poofypigeon/monostable-555/monostable_555.pdf

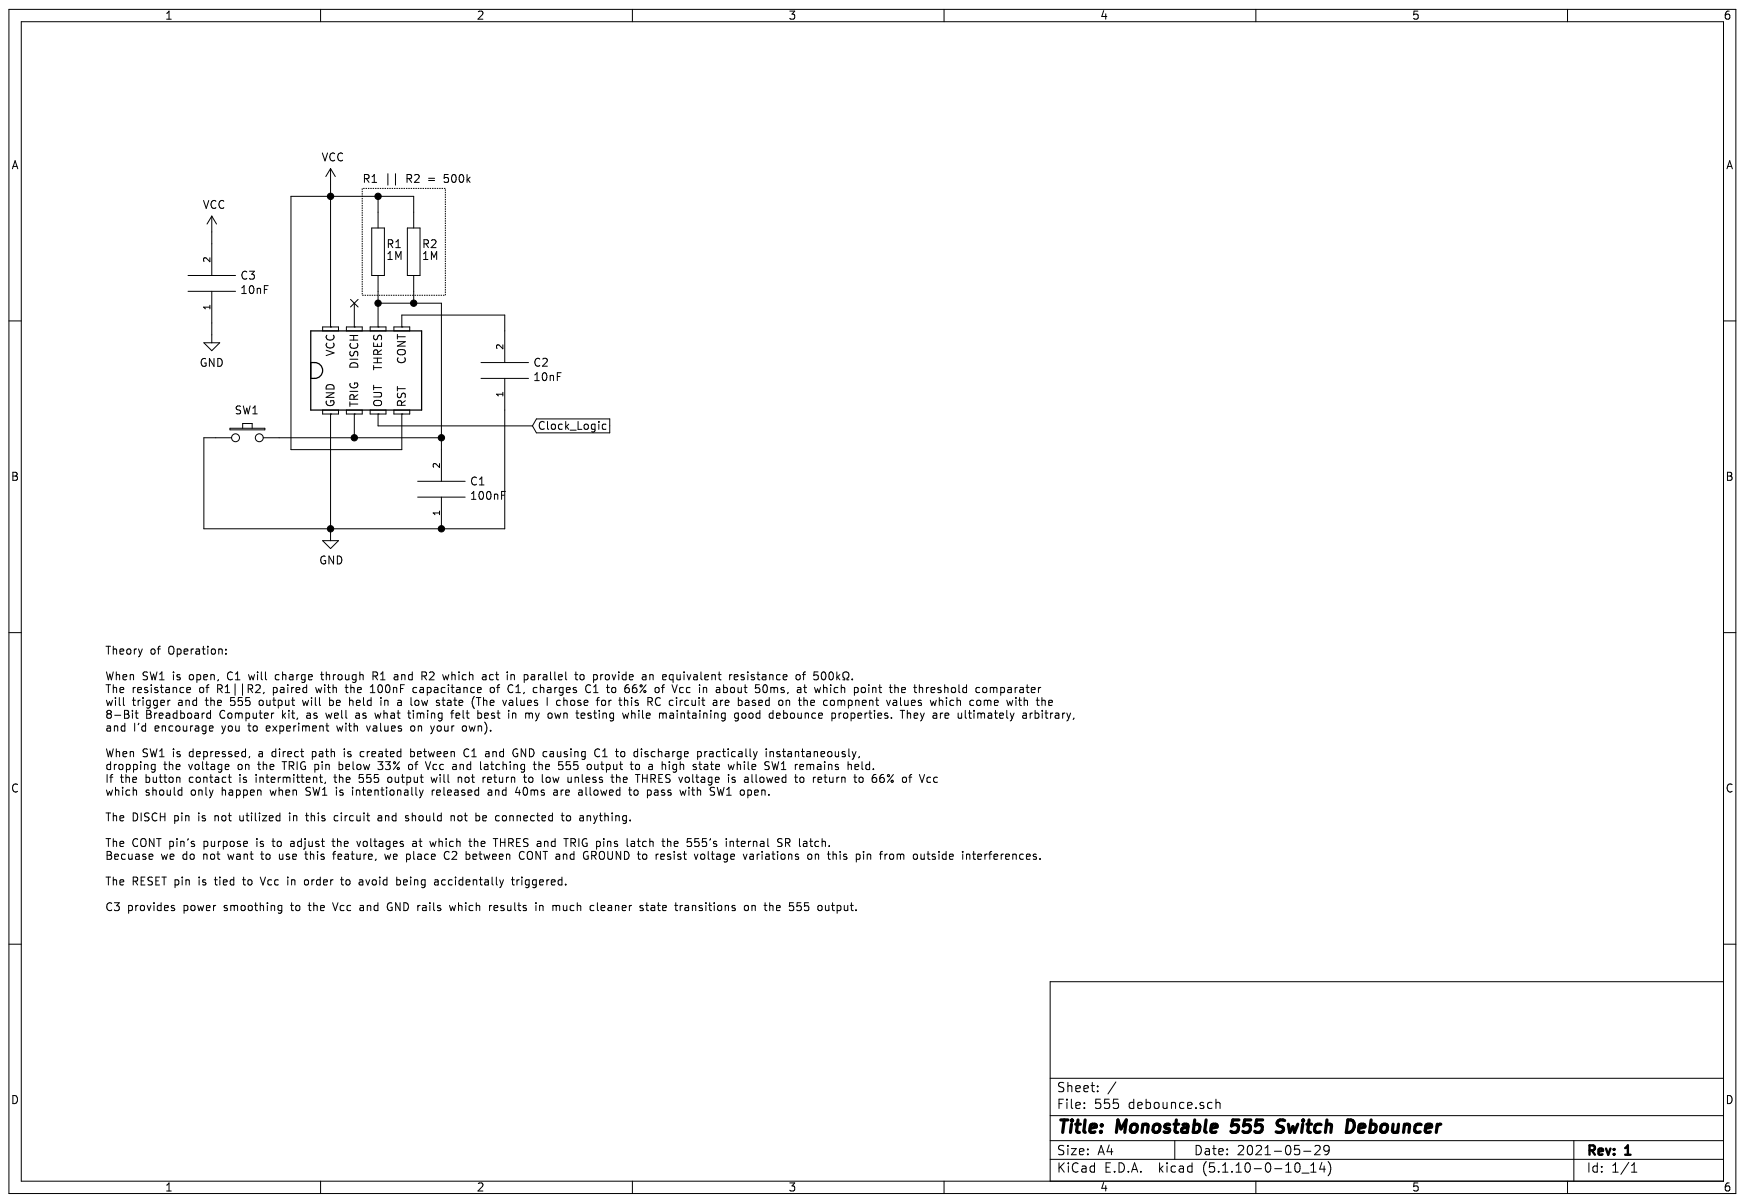
[picture p1: page 1]
