poofypigeon/monostable-555/kicad files/555 debounce.sch

## KiCad design kicad files/555 debounce.sch (2021-06-09)

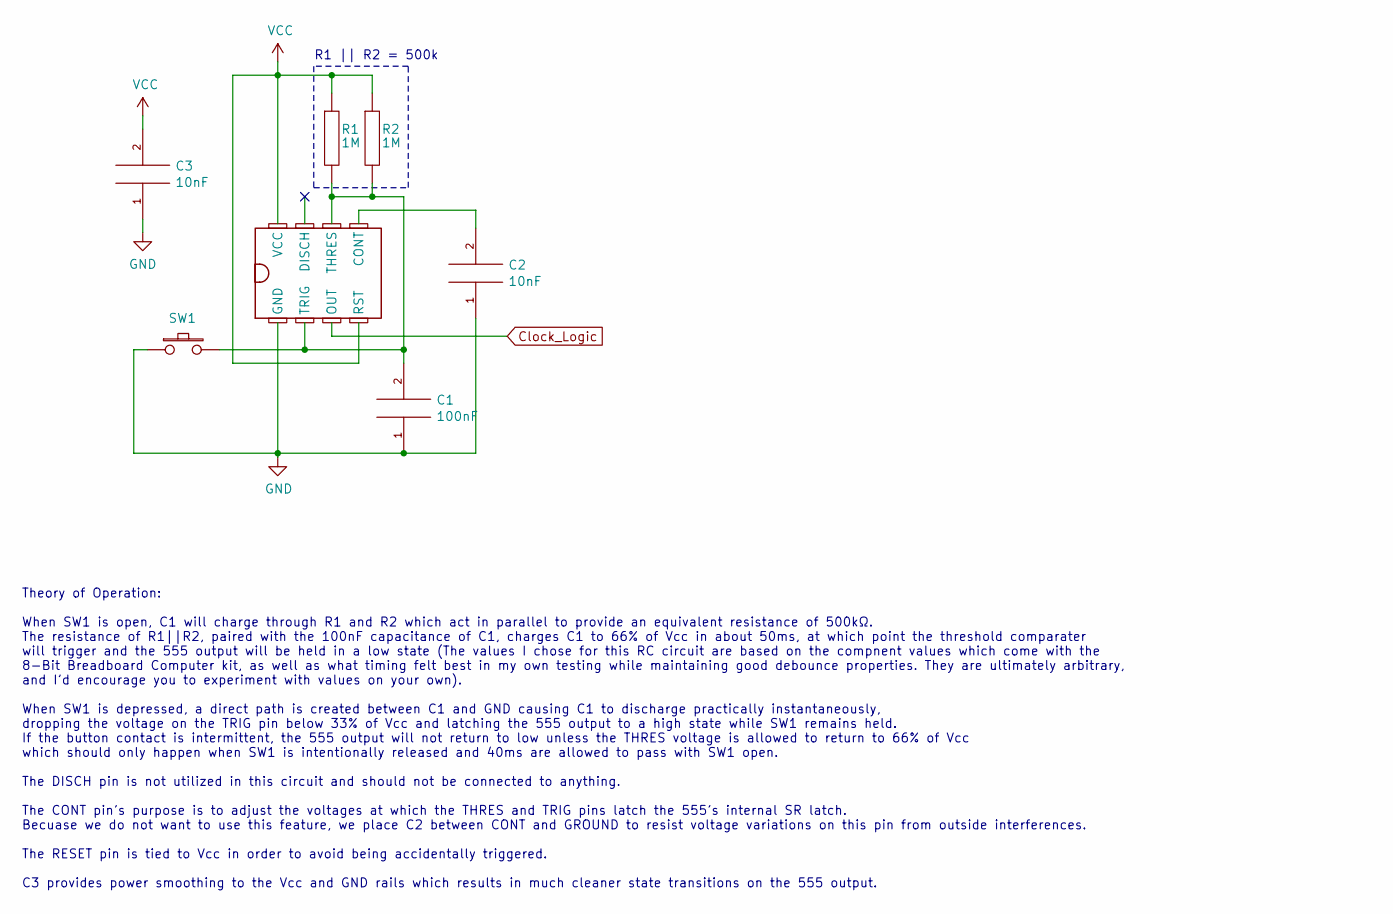
[picture p2: schematic 555 debounce.sch]

Parts:
C1: 100nF
C2, C3: 10nF
R1, R2: 1M
SW1: SW_PUSH_BUTTON

Connections:
GND: C1.1, C2.1, C3.1, SW1.1
unnamed: C1.2, R1.2, R2.2, SW1.2
VCC: C3.2, R1.1, R2.1

Notes on the sheet:
R1 || R2 = 500k
Theory of Operation: When SW1 is open, C1 will charge through R1 and R2 which act in parallel to provide an equivalent resistance of 500kΩ. The resistance of R1||R2, paired with the 100nF capacitance of C1, charges C1 to 66% of Vcc in about 50ms, at which point the threshold comparater will trigger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
